Alan-JH/Batt-Discharger/README.md

# Batt-Discharger
High current battery storage discharger for TJ UAV
