Alan-JH/Batt-Discharger/discharger/discharger.step

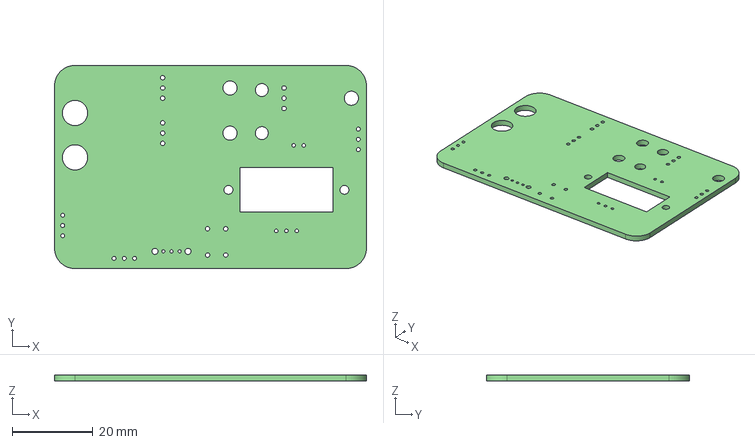
[picture p1: CAD file, 2022-10-31]
discharger/discharger.step
77.2 x 50.3 x 1.60 mm
