Alan-JH/Batt-Discharger/discharger/discharger.kicad_pcb

## KiCad design discharger/discharger.kicad_pcb (2022-11-11)

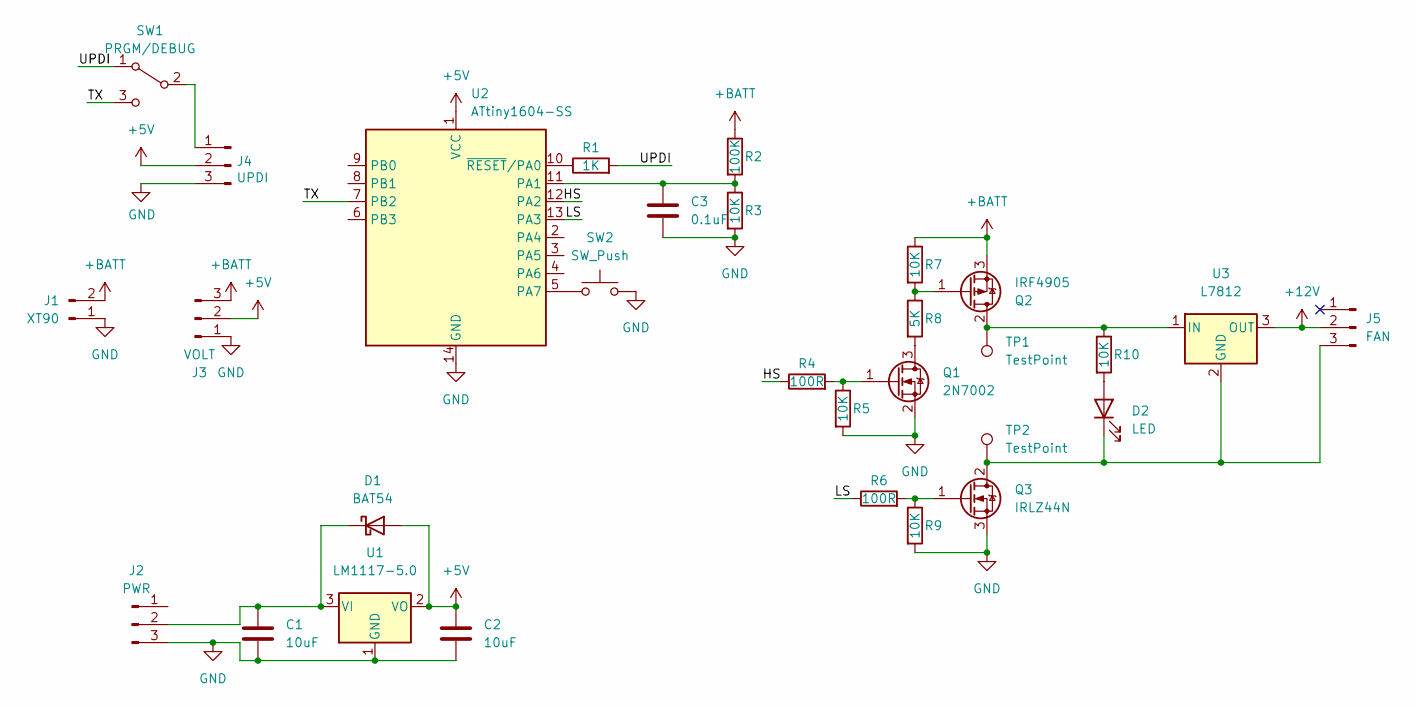
[picture p2: schematic discharger.kicad_sch]

Parts:
C1, C2: 10uF; C_0805_2012Metric
C3: 0.1uF; C_0805_2012Metric
D1: BAT54; D_SOD-123
D2: LED; LED_D5.0mm
J1: XT90
J2: PWR; PinHeader_1x03_P2.54mm_Vertical
J3: VOLT; BattMonitor
J4: UPDI; PinHeader_1x03_P2.54mm_Vertical
J5: FAN; PinHeader_1x03_P2.54mm_Vertical
Q1: 2N7002; SOT-23
Q2: IRF4905; TO-220-3_Horizontal_TabDown
Q3: IRLZ44N; TO-220-3_Horizontal_TabDown
R1: 1K; R_1206_3216Metric
R2: 100K; R_1206_3216Metric
R3, R5, R7, R9, R10: 10K; R_1206_3216Metric
R4, R6: 100R; R_1206_3216Metric
R8: 5K; R_1206_3216Metric
SW1: PRGM/DEBUG; SW_Slide_1P2T_CK_OS102011MS2Q
SW2: SW_Push; SW_PUSH_6mm
TP1, TP2: TestPoint; MountingHole_3.2mm_M3_DIN965_Pad
U1: LM1117-5.0; SOT-223-3_TabPin2
U2: ATtiny1604-SS; SOIC-14_3.9x8.7mm_P1.27mm
U3: L7812; TO-220-3_Horizontal_TabDown

Connections:
+12V: J5.2, U3.3 (OUT)
+BATT: J1.2, J3.3, Q2.3 (S), R2.1, R7.1
/HS: R4.1, U2.12 (PA2)
/LS: R6.1, U2.13 (PA3)
/TX: SW1.3 (C), U2.7 (PB2)
/UPDI: R1.2, SW1.1 (A)
GND: C1.2, C2.2, C3.2, J1.1, J2.3, J3.1, J4.3, Q1.2 (S), Q3.3 (S), R3.2, R5.2, R9.2, SW2.2, U1.1 (GND), U2.14 (GND)
unnamed: C1.1, D1.1 (K), J2.2, U1.3 (VI)
unnamed: C3.1, R2.2, R3.1, U2.11 (PA1)
unnamed: D2.1 (K), J5.3, Q3.2 (D), TP2.1, U3.2 (GND)
unnamed: D2.2 (A), R10.2
unnamed: J4.1, SW1.2 (B)
unnamed: Q1.1 (G), R4.2, R5.1
unnamed: Q1.3 (D), R8.2
unnamed: Q2.1 (G), R7.2, R8.1
unnamed: Q2.2 (D), R10.1, TP1.1, U3.1 (IN)
unnamed: Q3.1 (G), R6.2, R9.1
unnamed: R1.1, U2.10 (~RESET/PA0)
unnamed: SW2.1, U2.5 (PA7)

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
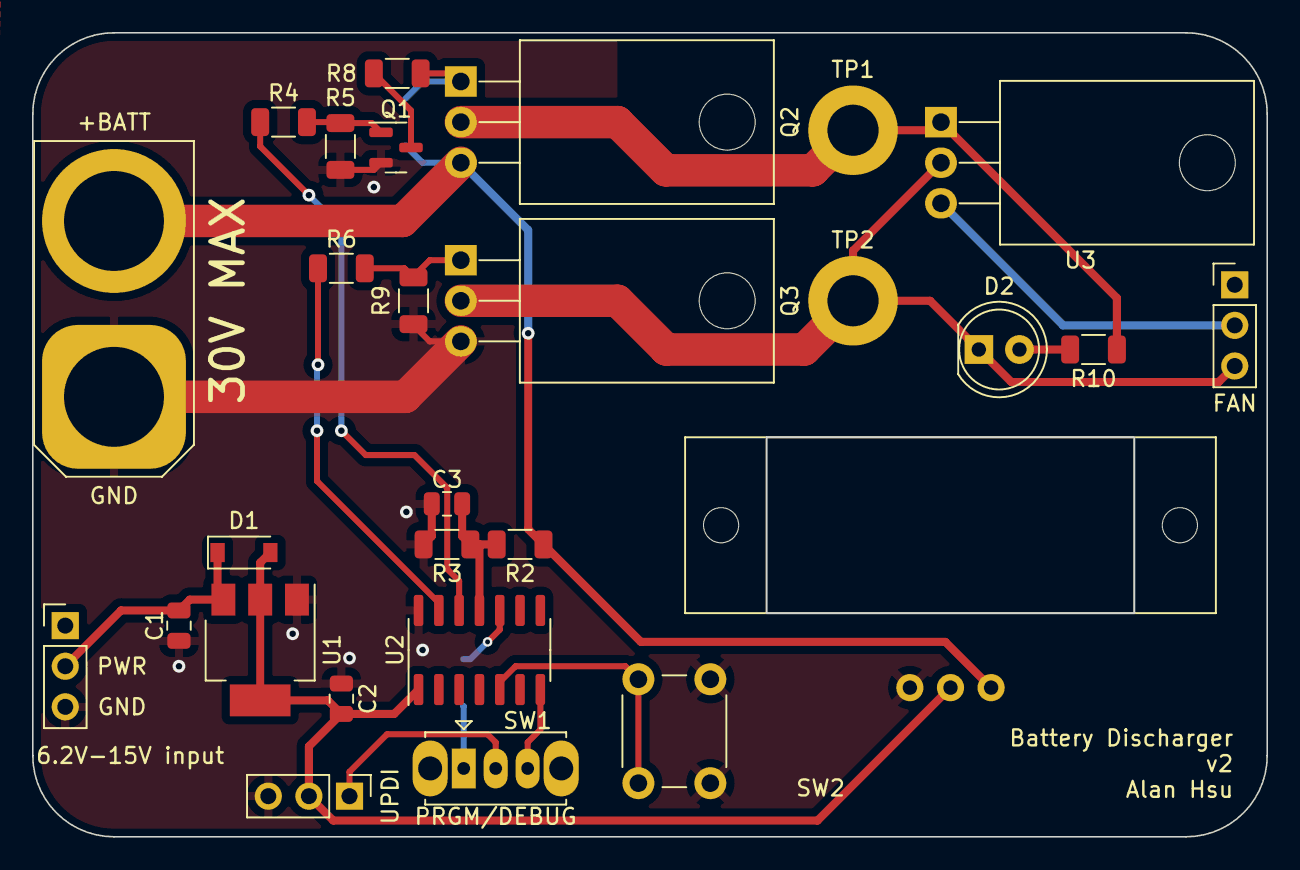
[picture p3: board discharger.kicad_pcb from above]

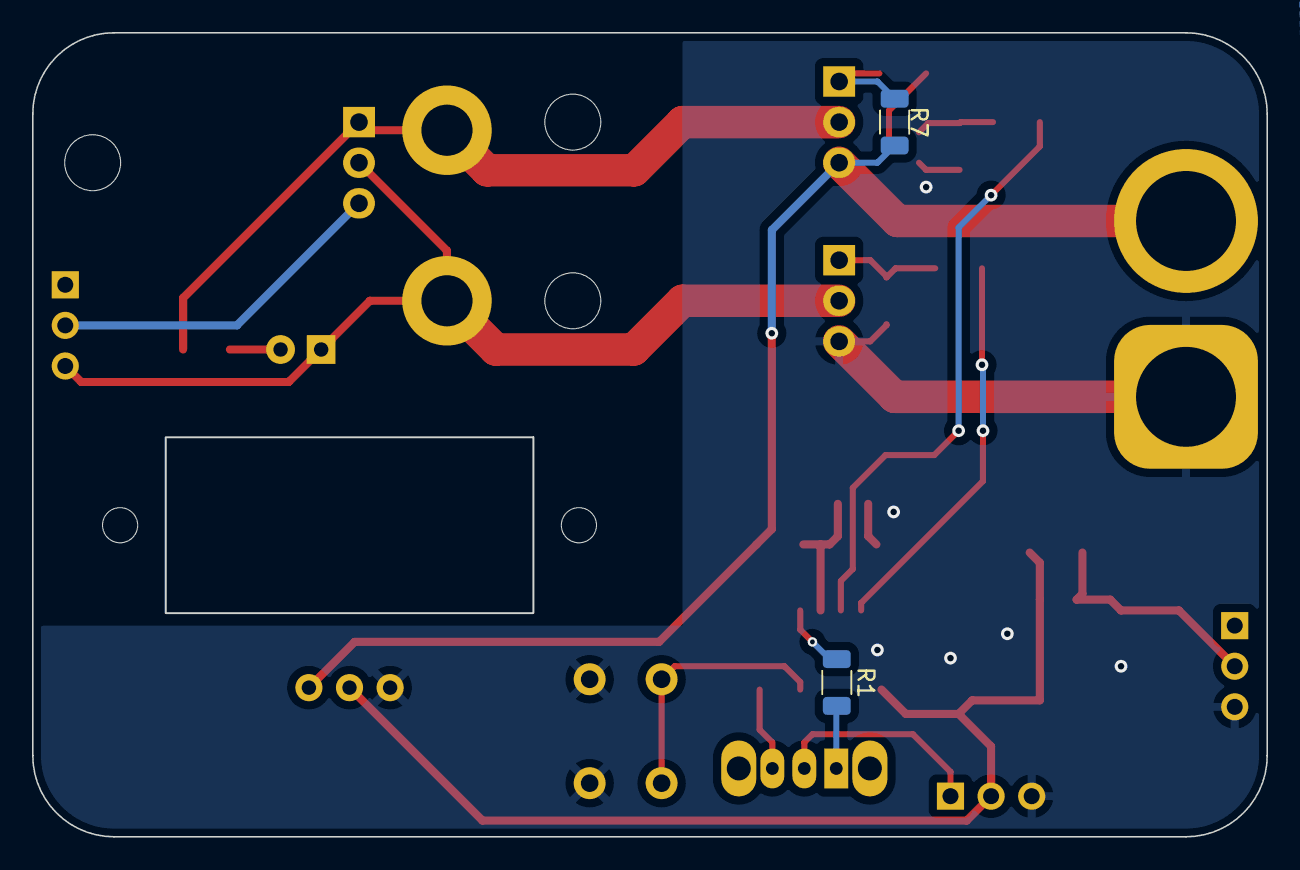
[picture p4: board discharger.kicad_pcb from below]

Board: 2 copper layers, 77.2 x 50.3 mm, 30 parts (2 on the bottom side), 20 nets.
