Alan-JH/Batt-Discharger/(commit log)

2022-09-12 initial schematic and footprints
    [discharger.kicad_pcb, discharger.kicad_sch]
2022-10-27 finish routing and gerbers
    [discharger-B_Cu.gbr, discharger-B_Mask.gbr, discharger-B_Paste.gbr, discharger-B_Silkscreen.gbr, discharger-Edge_Cuts.gbr, discharger-F_Cu.gbr, discharger-F_Mask.gbr, discharger-F_Paste.gbr]
2022-10-31 correct max input voltage, STEP export
    [discharger-B_Cu.gbr, discharger-B_Mask.gbr, discharger-B_Paste.gbr, discharger-B_Silkscreen.gbr, discharger-Edge_Cuts.gbr, discharger-F_Cu.gbr, discharger-F_Mask.gbr, discharger-F_Paste.gbr]
2022-10-31 fix xt90 pth size
    [discharger-B_Cu.gbr, discharger-B_Mask.gbr, discharger-B_Paste.gbr, discharger-B_Silkscreen.gbr, discharger-Edge_Cuts.gbr, discharger-F_Cu.gbr, discharger-F_Mask.gbr, discharger-F_Paste.gbr]
2022-11-11 5V instead of 3.3V
    [discharger.kicad_pcb, discharger.kicad_sch]
